FanHuaLady/rock_burst_robot/Docs/硬件资源与引脚分配.md

# 硬件资源与模块引脚

## 以太网 LAN8720A

| 功能 | MCU 引脚 | 网络名 | 备注 |
| --- | --- | --- | --- |
| RMII 参考时钟 | PA1 | `RMII_REF_CLK` | LAN8720A `nINT/REFCLKO` |
| MDIO | PA2 | `ETH_MDIO` | LAN8720A 管理接口 |
| MDC | PC1 | `ETH_MDC` | LAN8720A 管理接口 |
| CRS_DV | PA7 | `RMII_CRS_DV`  | RMII 接收控制 |
| RXD0 | PC4 | `RMII_RXD0` | RMII 接收数据 0 |
| RXD1 | PC5 | `RMII_RXD1` | RMII 接收数据 1 |
| TX_EN | PB11 | `RMII_TX_EN` | RMII 发送使能 |
| TXD0 | PB12 | `RMII_TXD0` | RMII 发送数据 0 |
| TXD1 | PB13 | `RMII_TXD1` | RMII 发送数据 1 |
| PHY 复位 | PC0 | `ETH_RESET` | LAN8720A `nRST` |

## RS485 SP3485

| 功能 | MCU 引脚 | 网络名 | SP3485 连接 |
| ---- | --- | --- | --- |
| 方向控制 | PA8 | `SP3485_CTIL` | `RE#` / `DE` |
| TXD  | PA9 | `SP3485_TXD`  | `DI` |
| RXD  | PA10 | `SP3485_RXD`  | `RO` |

## MAX22216 A 组 / 液压控制 1

| 功能 | MCU 引脚 | 网络名 | 备注 |
| --- | --- | --- | --- |
| SPI SCK  | PB10 | `M_A_SCK` | U6 MAX22216 |
| SPI MISO | PC2 | `M_A_MISO` | U6 MAX22216 |
| SPI MOSI | PC3 | `M_A_MOSI` | U6 MAX22216 |
| 片选 | PB14 | `M_A_CS` | U6 MAX22216 |
| 使能 | PB15 | `M_A_ENABLE` | U6 MAX22216 |
| DIR0 | PE7 | `M_A_DIR_0`  | 控制接口 1-A0 |
| DIR1 | PB2 | `M_A_DIR_1`  | 控制接口 1-A1 |
| DIR2 | PB1 | `M_A_DIR_2`  | 控制接口 1-A2 |
| DIR3 | PB0 | `M_A_DIR_3`  | 控制接口 1-A3 |

## MAX22216 B 组 / 液压控制 2

| 功能 | MCU 引脚 | 网络名 | 备注 |
| --- | --- | --- | --- |
| SPI SCK  | PB3 | `M_B_SCK` | U7 MAX22216 |
| SPI MISO | PB4 | `M_B_MISO` | U7 MAX22216 |
| SPI MOSI | PB5 | `M_B_MOSI` | U7 MAX22216 |
| 片选 | PB6 | `M_B_CS` | U7 MAX22216 |
| 使能 | PB7 | `M_B_ENABLE` | U7 MAX22216 |
| DIR0 | PE3 | `M_B_DIR_0`  | 控制接口 2-B0 |
| DIR1 | PE2 | `M_B_DIR_1`  | 控制接口 2-B1 |
| DIR2 | PE1 | `M_B_DIR_2`  | 控制接口 2-B2 |
| DIR3 | PE0 | `M_B_DIR_3`  | 控制接口 2-B3 |

## MAX22216 C 组 / 液压控制 3

| 功能 | MCU 引脚 | 网络名 | 备注 |
| --- | --- | --- | --- |
| SPI SCK  | PC10 | `M_C_SCK` | U8 MAX22216 |
| SPI MISO | PC11 | `M_C_MISO` | U8 MAX22216 |
| SPI MOSI | PC12 | `M_C_MOSI` | U8 MAX22216 |
| 片选 | PD0 | `M_C_CS` | U8 MAX22216 |
| 使能 | PD1 | `M_C_ENABLE` | U8 MAX22216 |
| DIR0 | PD7 | `M_C_DIR_0`  | 控制接口 3-C0 |
| DIR1 | PD6 | `M_C_DIR_1`  | 控制接口 3-C1 |
| DIR2 | PA12 | `M_C_DIR_2`  | 控制接口 3-C2 |
| DIR3 | PA11 | `M_C_DIR_3`  | 控制接口 3-C3 |

## GP8403 DAC 接口

| 功能  | MCU 引脚 | 网络名 | 备注 |
| --- | --- | --- | --- |
| SCL | PB8 | `GP8403_SCL` | H3 DAC 接口 |
| SDA | PB9 | `GP8403_SDA` | H3 DAC 接口 |

## 继电器

| 功能 | MCU 引脚 | 网络名 | 备注 |
| --- | --- | --- | --- |
| 控制输出 | PA3 | `RELAY` | 高电平吸合继电器 |

## LED

| 功能 | MCU 引脚 | 网络名 | 备注 |
| ---- | --- | --- | ---- |
| LED1 | PD4 | `LED1` | LED5 |
| LED2 | PD5 | `LED2` | LED6 |

## 按键

| 功能 | MCU 引脚 | 网络名 | 备注  |
| ---- | --- | --- | --- |
| 按键 1 | PD13 | `BUTTON1` | U21 |
| 按键 2 | PD14 | `BUTTON2` | U15 |

## 霍尔传感器接口

| 功能 | MCU 引脚 | 网络名 | 备注 |
| --- | --- | ----- | --- |
| POS 输入 | PD8 | `POS` | 经 U14 EL357NB 隔离 |

## 油门 PWM

| 功能 | MCU 引脚 | 网络名 | 备注 |
| --- | --- | ----- | --- |
| PWM 输出 | PD12 | `PWM` | 经 U12 VOH1016AB-T2 隔离 |

## 车灯

| 功能 | MCU 引脚 | 网络名 | 备注  |
| ---- | --- | --- | --- |
| 车灯 1 | PD2 | `HIGHTS`  | K13 |
| 车灯 2 | PD3 | `HIGHTS2` | K14 |
