FanHuaLady/rock_burst_robot/Quotes/Quotes.md

# 岩爆机器人耗材购买清单

| 元件名 | 简称 | 数量 | 单价 | 总价 | 实付款 | 是否已买 | 购买原因 |
|:---:|:---:|:----:|:-----:|:---:|:---:|:----:|:---:|
| MAX22216ATJY+ | 电流输出 | 3 | 39.33 | 117.99 | 123.00 | 确认 | 岩爆液压控制 |
| G6K-2F-Y DC12 | 小白继电器 | 12+8 | 1.70  | 34 | 39.00  | 确认 | 岩爆液压控制 |
| G5Q-14 DC24 | 大黑继电器 | 2+4  | 2.63  | 15.78  | 15.80  | 确认 | 岩爆车灯控制 |
| 一开一闭DC24V继电器 | 车灯继电器 | 1 | 16.8  | 16.8 | | 未确认  | 岩爆车灯控制 |
| VOH1016AB-T2 | 高速光耦 | 1 | 8.50  | 8.50 | 13.50  | 确认 | 岩爆油门 |
| 100个2.2uF 50V电容 | 2.2uF电容 | 1 | 10 | 10 | | 未确认  | 常用 |
| 8MHz 4脚晶振 | 8MHz晶振  | 20 | 0.75  | 15 | | 未确定  | STM32F4常用 |
| 25MHz 2脚晶振 | 25MHz晶振 | 20 | 0.83  | 16.6 | | 未确定  | 网口芯片常用 |
| SMF6.5CA | | 50 | 0.06  | 3 | | 未确定  | 485需要 |
| SMAJ5.0A | | 20 | 2.2 | | | 未确定  | 5V转3.3V |
| KF128 3.5m's | | | | | | | |
