FanHuaLady/rock_burst_robot/PCB/原理图.pdf

# BOOT

下载接口 | 24V转5V

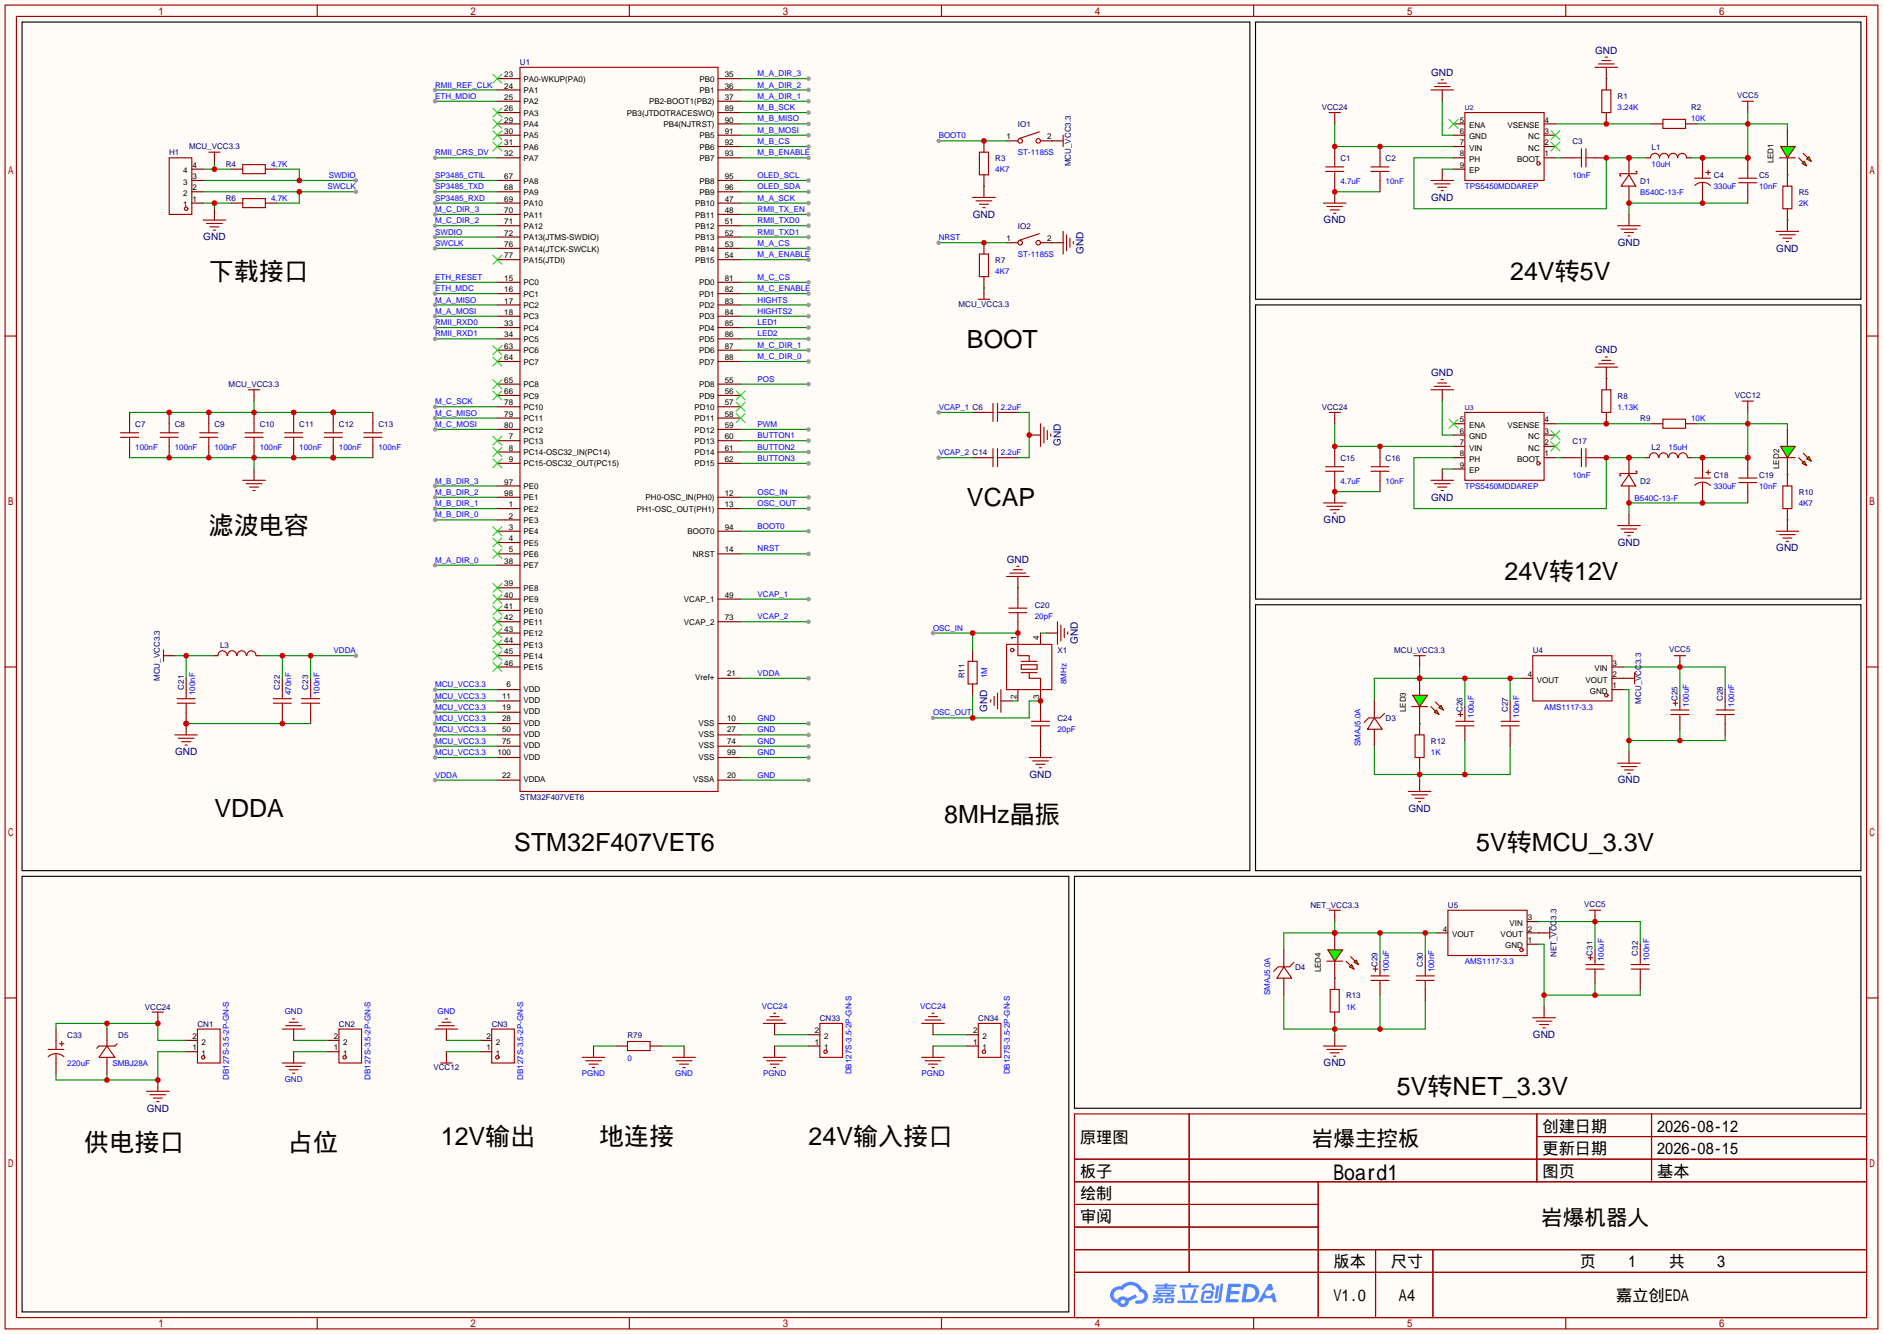
[picture p1: page 1]

原理图 | 岩爆主控板 | 创建日期 | 2026-08-12

更新日期 | 2026-08-15

板子 | Board1 | 图页 | 基本
绘制 | | 岩爆机器人
审阅

V1.0 | A4 | 嘉立创EDA

## D9 1N⁴⁰⁰⁷WS

## D7 1N⁴⁰⁰⁷WS

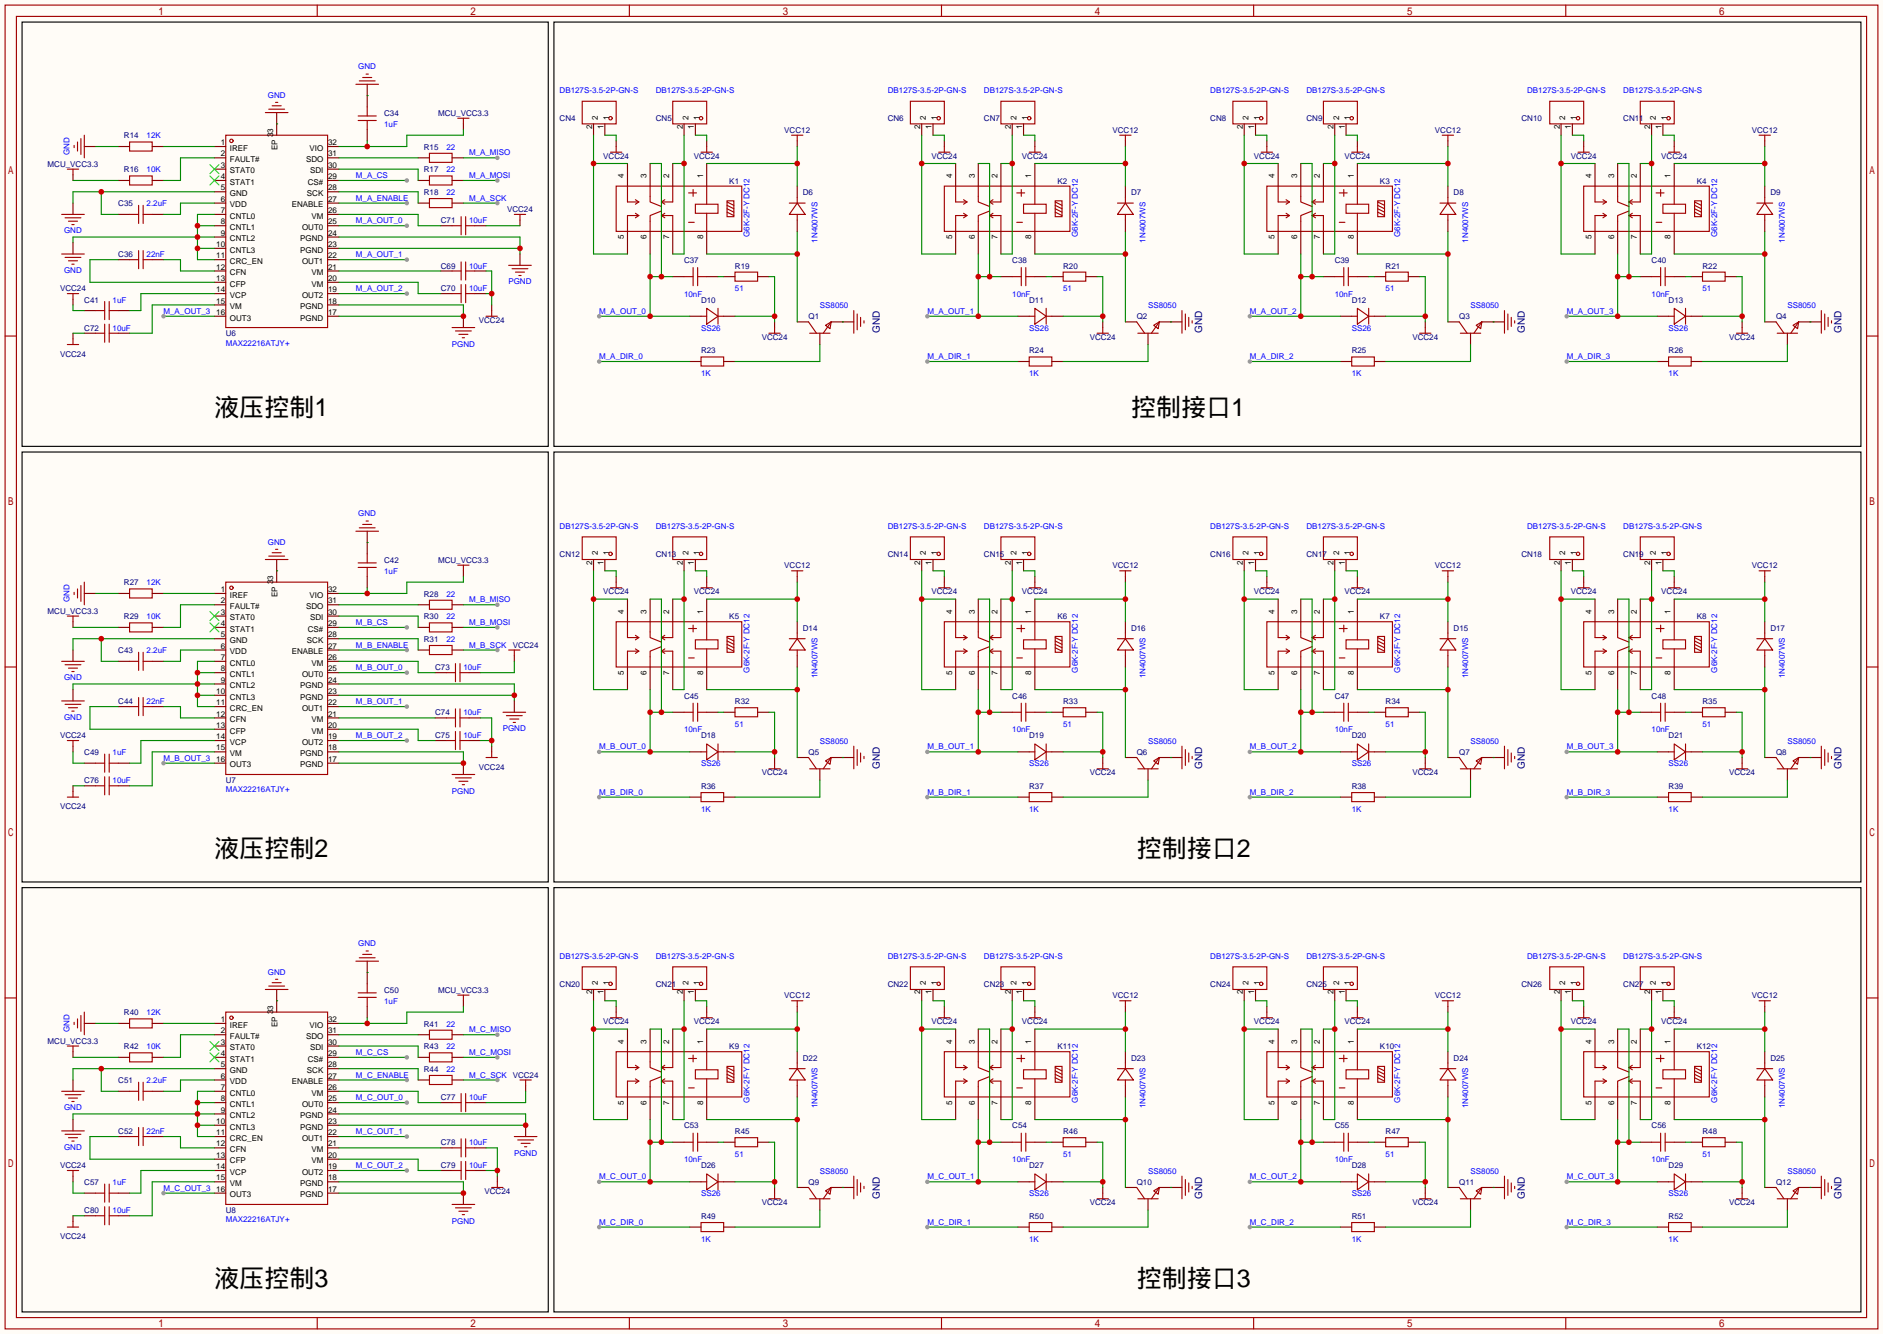
[picture p2: page 2]

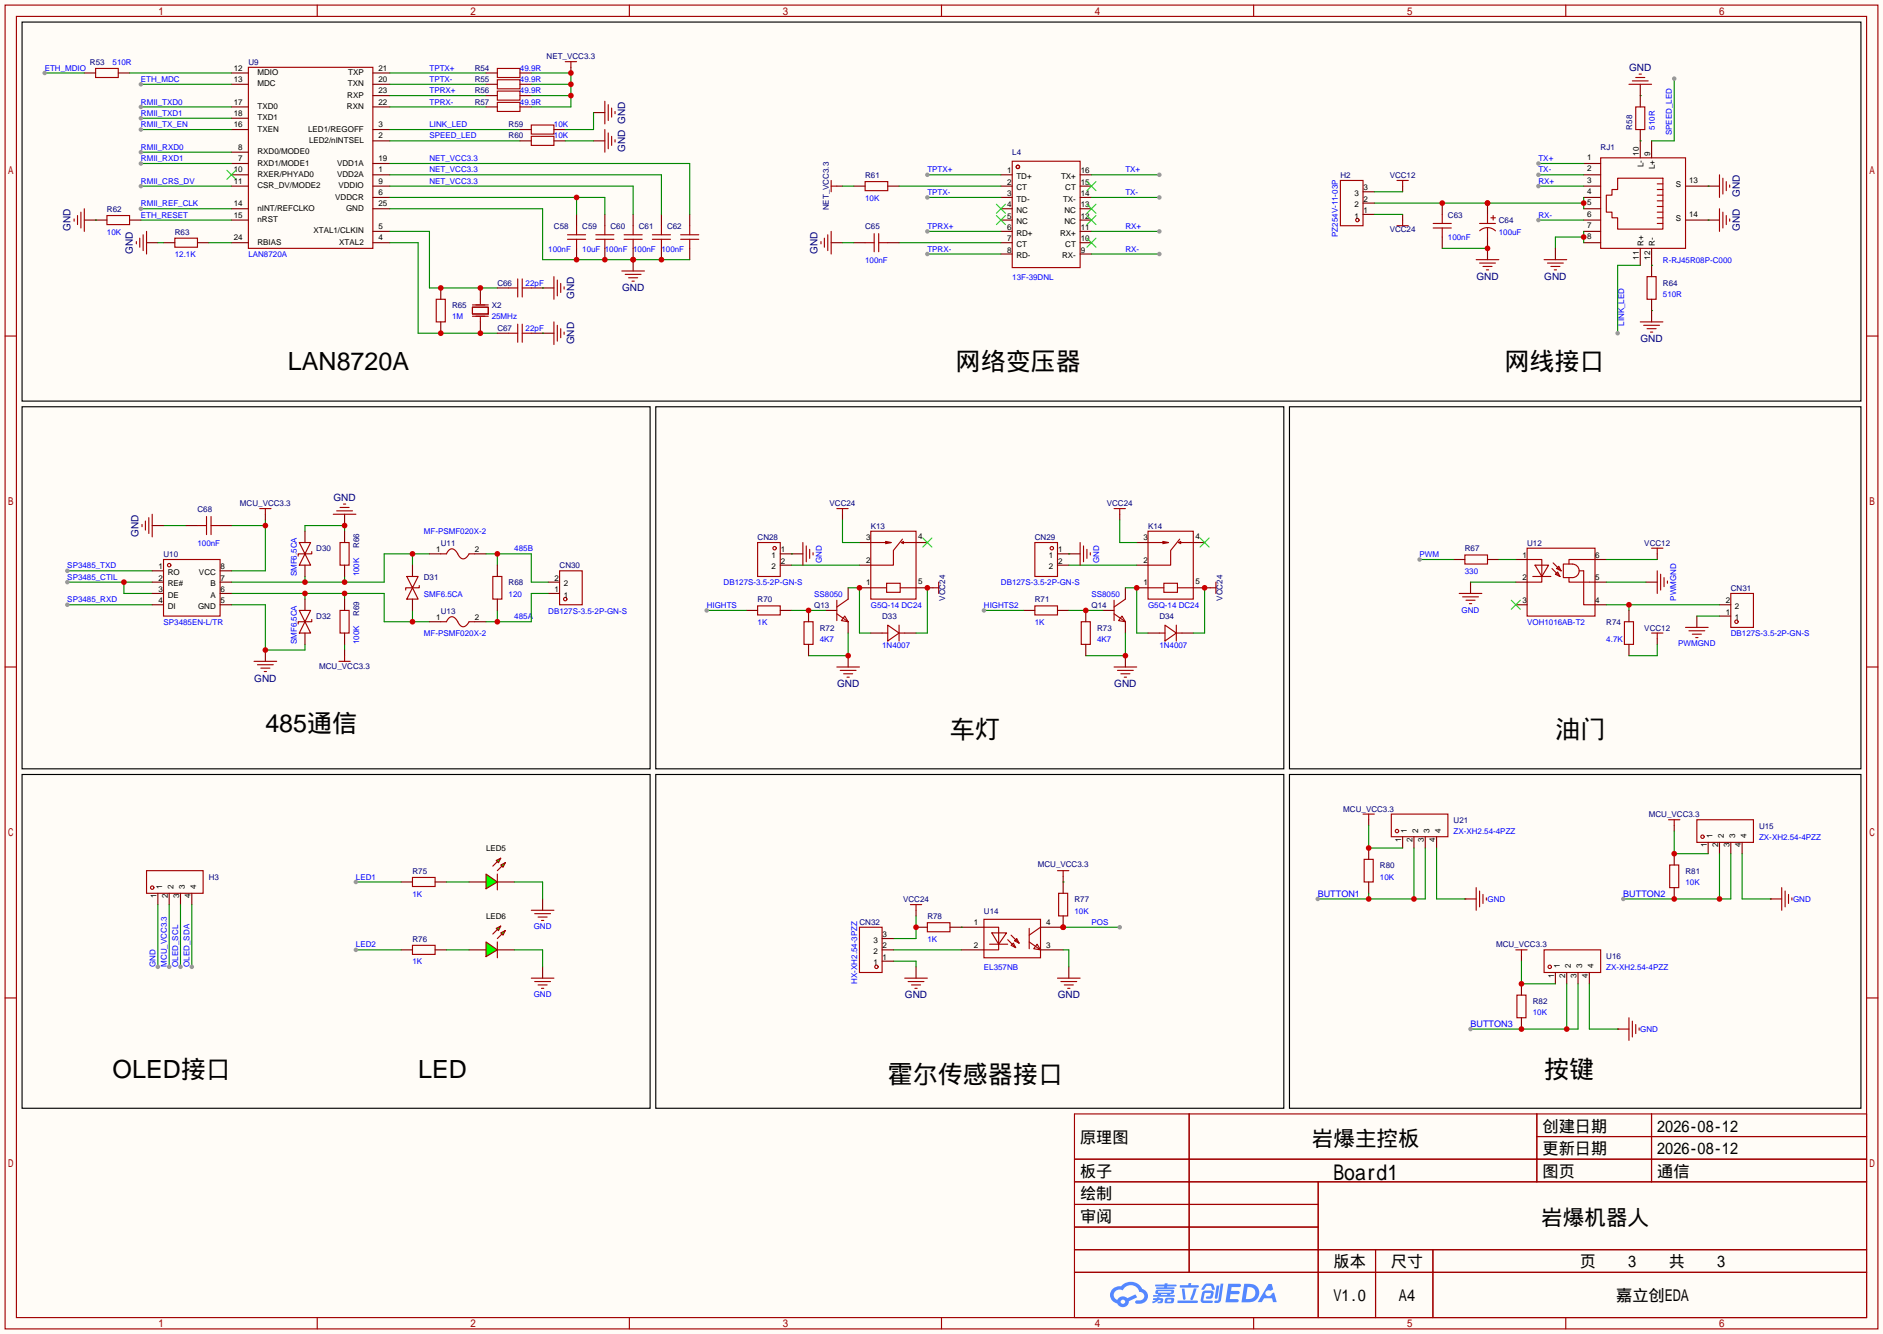
[picture p3: page 3]

原理图 | 岩爆主控板 | 创建日期 | 2026-08-12

更新日期 | 2026-08-12

板子 | Board1 | 图页 | 通信
绘制 | | 岩爆机器人
审阅

V1.0 | A4 | 嘉立创EDA
